LaserRackBoards/Attenuator/attenuator.kicad_pcb

## KiCad design attenuator.kicad_pcb (2025-11-20)

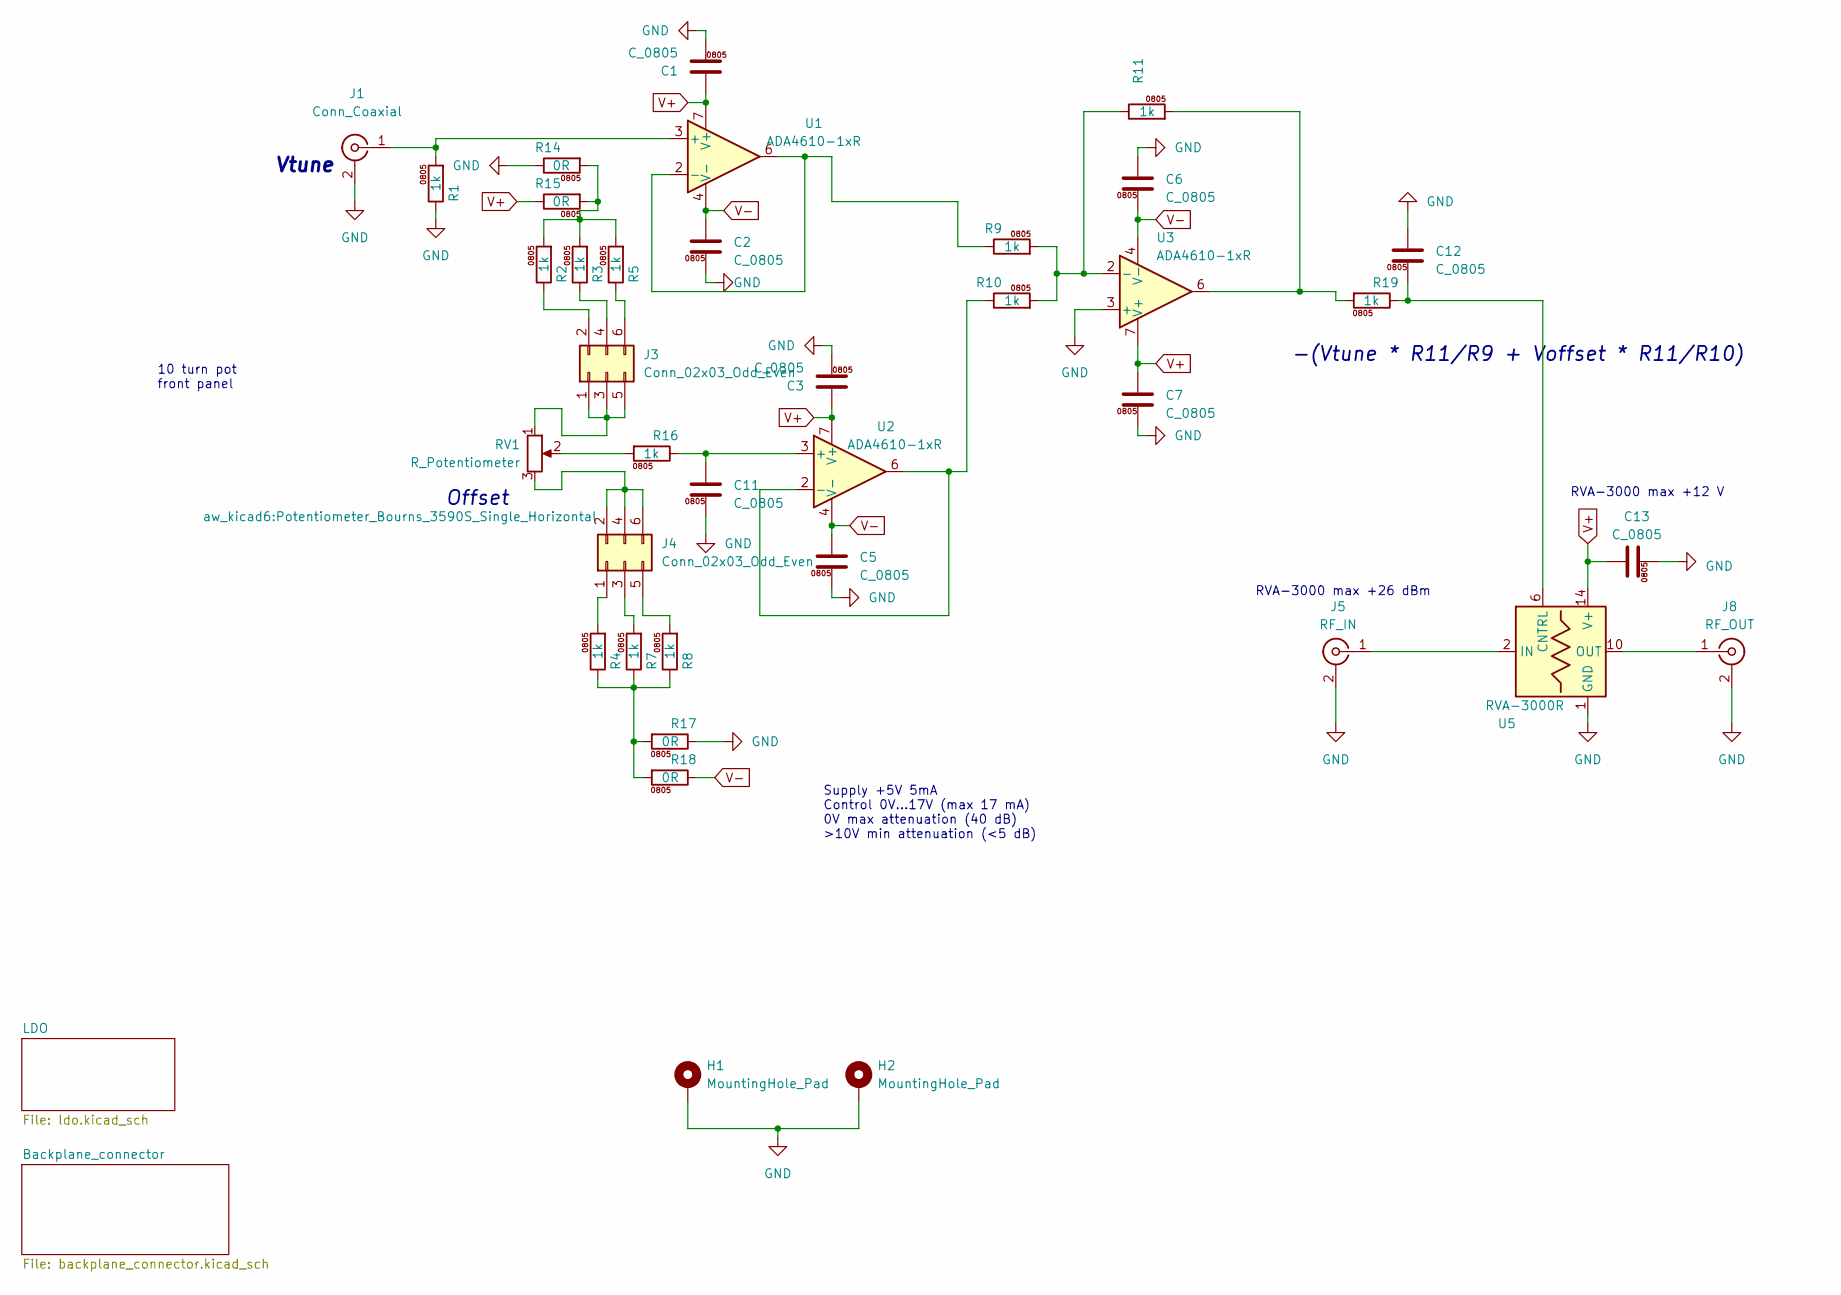
[picture p2: schematic attenuator.kicad_sch, Voltage Controlled Attenuator]

Parts:
C1, C2, C3, C5, C6, C7, C11, C12, C13: C_0805; C_0805_2012Metric
H1, H2: MountingHole_Pad; MountingHole_2.7mm_M2.5_DIN965_Pad
J1: Conn_Coaxial; BNC_Amphenol_B6252HB-NPP3G-50_Horizontal
J3, J4: Conn_02x03_Odd_Even; PinHeader_2x03_P2.54mm_Vertical
J5: RF_IN; SMA_Molex_73251-2200_Horizontal
J8: RF_OUT; SMA_Molex_73251-2200_Horizontal
R1, R2, R3, R4, R5, R7, R8, R9, R10, R11, R16, R19: 1k; R_0805_2012Metric
R14, R15, R17, R18: 0R; R_0805_2012Metric
RV1: R_Potentiometer; Potentiometer_Bourns_3590S_Single_Horizontal
U1, U2, U3: ADA4610-1xR; SOIC-8_3.9x4.9mm_P1.27mm
U5: RVA-3000R; Mini-Circuits_CK605

Connections:
GND: C1.2, C2.2, C3.2, C5.2, C6.1, C7.2, C11.2, C12.1, C13.2, H1.1, H2.1, J1.2 (Ext), J5.2 (Ext), J8.2 (Ext), R1.1, R14.1, R17.1, U3.3 (+), U5.1 (GND), U5.3 (GND), U5.4 (GND), U5.5 (GND), U5.7 (GND), U5.8 (GND), U5.9 (GND), U5.11 (GND), U5.12 (GND), U5.13 (GND), U5.15 (GND), U5.16 (GND); also elsewhere on the board
unnamed: J1.1 (In), R1.2, U1.3 (+)
unnamed: J3.1, J3.3, J3.5, RV1.1
unnamed: J3.2, R2.1
unnamed: J3.4, R3.1
unnamed: J3.6, R5.1
unnamed: J4.1, R4.2
unnamed: J4.2, J4.4, J4.6, RV1.3
unnamed: J4.3, R7.2
unnamed: J4.5, R8.2
unnamed: J5.1 (In), U5.2 (IN)
unnamed: J8.1 (In), U5.10 (OUT)
unnamed: R11.2, R19.2, U3.6
unnamed: R2.2, R3.2, R5.2, R14.2, R15.2
unnamed: R16.2, RV1.2
unnamed: R4.1, R7.1, R8.1, R17.2, R18.2
unnamed: R9.1, U1.2 (-), U1.6
unnamed: C11.1, R16.1, U2.3 (+)
unnamed: R10.1, U2.2 (-), U2.6
unnamed: R9.2, R10.2, R11.1, U3.2 (-)
unnamed: C12.2, R19.1, U5.6 (CNTRL)
V+: C1.1, C3.1, C7.1, C13.1, R15.1, U1.7 (V+), U2.7 (V+), U3.7 (V+), U5.14 (V+); also elsewhere on the board
V-: C2.1, C5.1, C6.2, R18.1, U1.4 (V-), U2.4 (V-), U3.4 (V-); also elsewhere on the board

Notes on the sheet:
RVA-3000 max +12 V
Supply +5V 5mA Control 0V...17V (max 17 mA) 0V max attenuation (40 dB) >10V min attenuation (<5 dB)
RVA-3000 max +26 dBm
Vtune
10 turn pot front panel
Offset
-(Vtune * R11/R9 + Voffset * R11/R10)

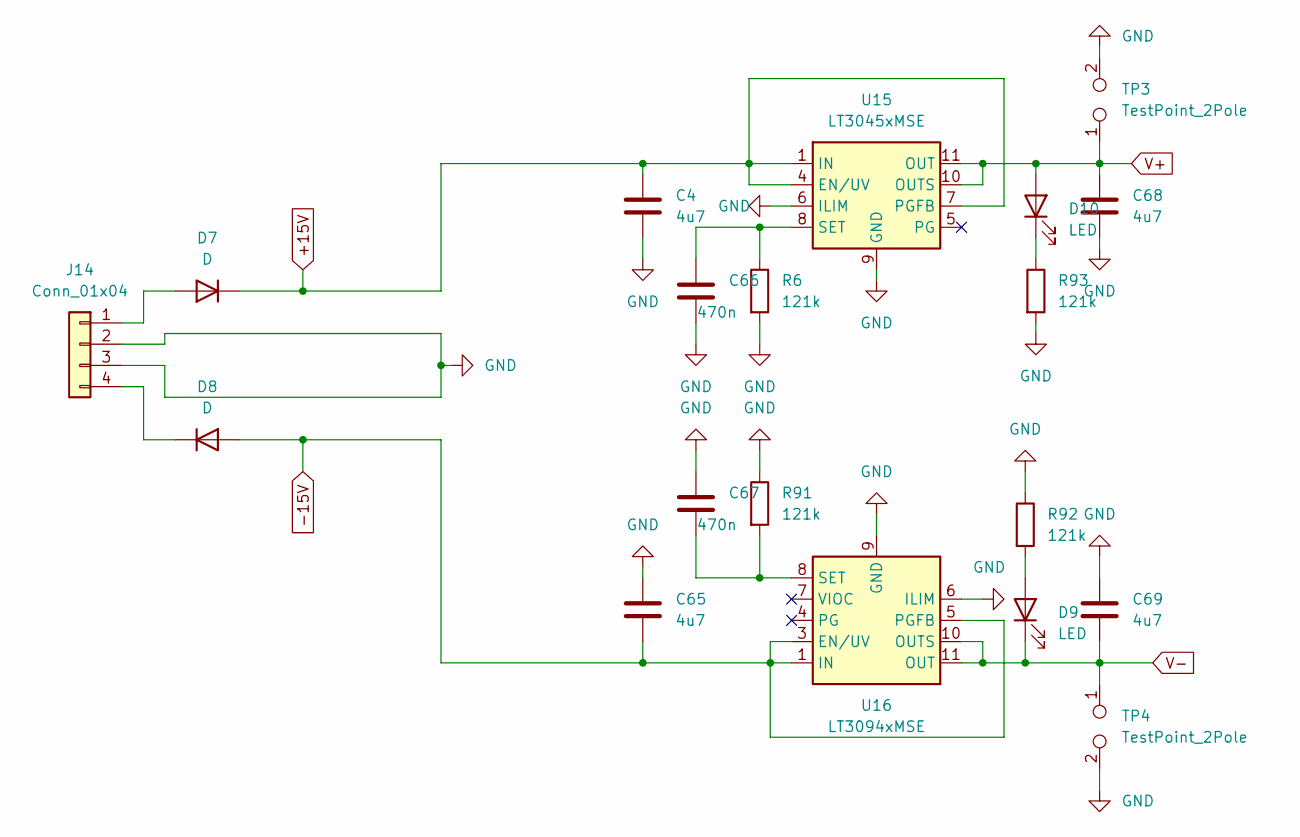
[picture p3: schematic ldo.kicad_sch]

Parts:
C4, C65, C68, C69: 4u7; C_0805_2012Metric
C66, C67: 470n; C_0805_2012Metric
D7, D8: D; D_SMB
D9, D10: LED; LED_0805_2012Metric
J14: Conn_01x04; TerminalBlock_TE_282834-4_1x04_P2.54mm_Horizontal
R6, R91, R92, R93: 121k; R_0805_2012Metric
TP3, TP4: TestPoint_2Pole; TestPoint_2Pads_Pitch2.54mm_Drill0.8mm
U15: LT3045xMSE; MSOP-12-1EP_3x4mm_P0.65mm_EP1.65x2.85mm
U16: LT3094xMSE; MSOP-12-1EP_3x4mm_P0.65mm_EP1.65x2.85mm

Connections:
+15V: C4.1, D7.1 (K), U15.1 (IN), U15.2 (IN), U15.3 (IN), U15.4 (EN/UV), U15.7 (PGFB); also elsewhere on the board
-15V: C65.2, D8.2 (A), U16.1 (IN), U16.2 (IN), U16.3 (EN/UV), U16.5 (PGFB), U16.13 (IN); also elsewhere on the board
GND: C4.2, C65.1, C66.2, C67.1, C68.2, C69.1, J14.2, J14.3, R6.2, R91.1, R92.1, R93.2, TP3.2, TP4.2, U15.6 (ILIM), U15.9 (GND), U15.13 (GND), U16.6 (ILIM), U16.9 (GND); also elsewhere on the board
unnamed: D7.2 (A), J14.1
unnamed: D8.1 (K), J14.4
unnamed: D9.2 (A), R92.2
unnamed: D10.1 (K), R93.1
unnamed: C66.1, R6.1, U15.8 (SET)
unnamed: C67.2, R91.2, U16.8 (SET)
V+: C68.1, D10.2 (A), TP3.1, U15.10 (OUTS), U15.11 (OUT), U15.12 (OUT); also elsewhere on the board
V-: C69.2, D9.1 (K), TP4.1, U16.10 (OUTS), U16.11 (OUT), U16.12 (OUT); also elsewhere on the board

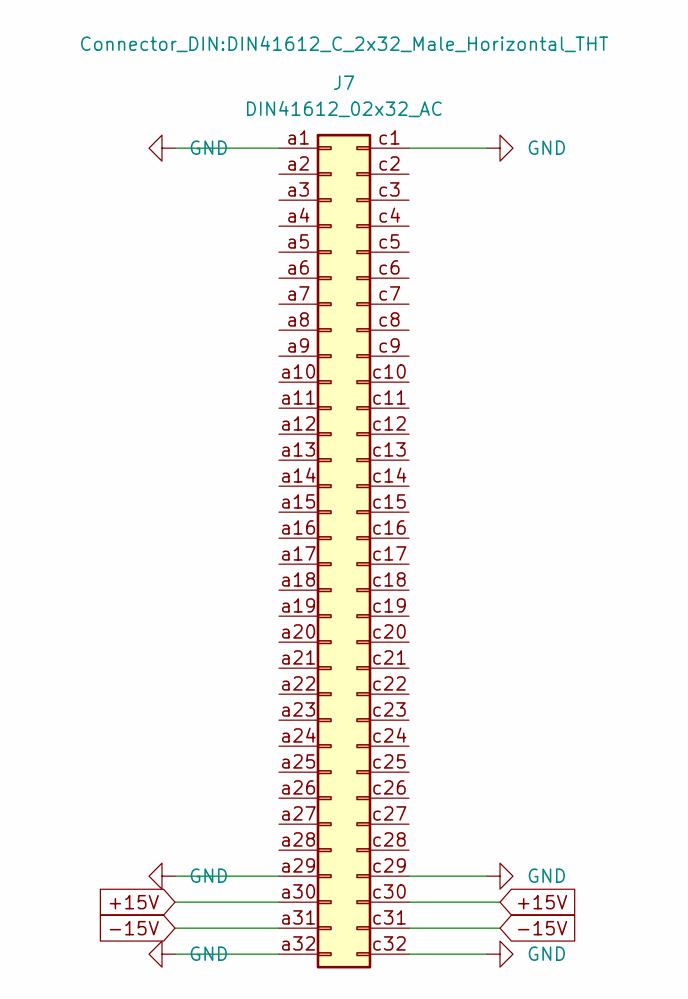
[picture p4: schematic backplane_connector.kicad_sch]

Parts:
J7: DIN41612_02x32_AC; DIN41612_C_2x32_Male_Horizontal_THT

Connections:
+15V: J7.a30, J7.c30; also elsewhere on the board
-15V: J7.a31, J7.c31; also elsewhere on the board
GND: J7.a1, J7.a29, J7.a32, J7.c1, J7.c29, J7.c32; also elsewhere on the board

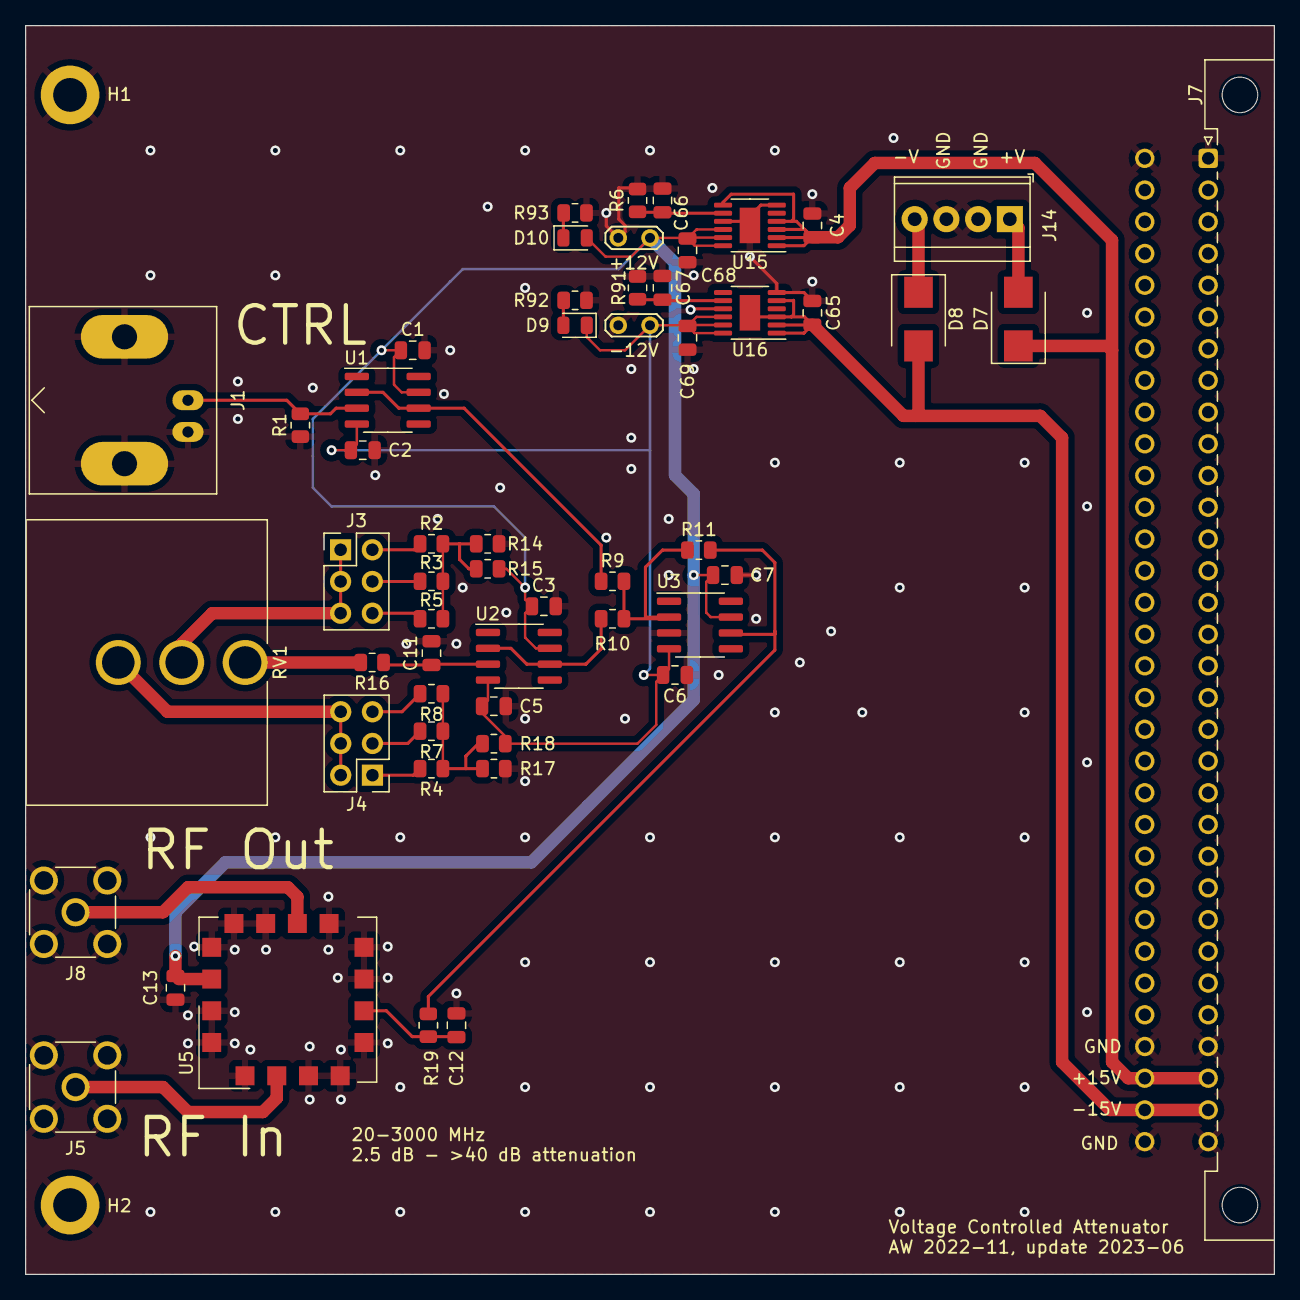
[picture p5: board attenuator.kicad_pcb from above]

Board: 2 copper layers, 100.0 x 100.0 mm, 57 parts (0 on the bottom side), 31 nets.

Other parts of the board:
+12V: TestPoint_2Pole; TestPoint_2Pads_Pitch2.54mm_Drill0.8mm
-12V: TestPoint_2Pole; TestPoint_2Pads_Pitch2.54mm_Drill0.8mm

Their connections:
GND: +12V.2, -12V.2; also elsewhere on the board
V+: +12V.1; also elsewhere on the board
V-: -12V.1; also elsewhere on the board
